markbennett95/dpdtFootSwitchBoard/README.md

# Footswitch Board

KiCAD files for a simple footswitch to ribbon cable board.

## v1.0.0-build
Uses a standard solder lug 3PDT foot switch, and an 8-conductor ribbon cable with 2.54mm pitch
