markbennett95/dpdtFootSwitchBoard/dpdtFootSwitchBoard.sch

## KiCad design dpdtFootSwitchBoard.sch (2024-02-09)

Schematic: dpdtFootSwitchBoard.sch

Parts:
J1: Conn_01x08; Pin_Header_Straight_1x06_Pitch2.54mm
SW1: SW_3PDT; SW_Foot_3PDT
