markbennett95/dpdtFootSwitchBoard/(commit log)

2021-10-09 created files, added schematic
    [footSwitchBoard.kicad_pcb, footSwitchBoard.sch]
2021-10-09 started PCB layout
    [footSwitchBoard.kicad_pcb, footSwitchBoard.sch]
2021-10-09 finished PCB
    [footSwitchBoard.kicad_pcb]
2021-10-10 added JLC batch number location
    [footSwitchBoard.kicad_pcb]
2021-10-10 generated gerber files
    [footSwitchBoard-B_Cu.gbr, footSwitchBoard-B_Mask.gbr, footSwitchBoard-B_Paste.gbr, footSwitchBoard-B_SilkS.gbr, footSwitchBoard-Edge_Cuts.gbr, footSwitchBoard-F_Cu.gbr, footSwitchBoard-F_Mask.gbr, footSwitchBoard-F_Paste.gbr]
2022-07-07 disconnected pin 9 from ground to allow more flexibility in LED switching
    [footSwitchBoard-B_Cu.gbr, footSwitchBoard-B_Mask.gbr, footSwitchBoard-B_Paste.gbr, footSwitchBoard-B_SilkS.gbr, footSwitchBoard-Edge_Cuts.gbr, footSwitchBoard-F_Cu.gbr, footSwitchBoard-F_Mask.gbr, footSwitchBoard-F_Paste.gbr]
2024-02-09 updated project
    [dpdtFootSwitchBoard.kicad_pcb, dpdtFootSwitchBoard.sch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]
